f1ac0/Water_heater_881163_control_board/README.md

# Thermostat + ACI pour chauffe eau Pacific - Thermor 881163 et modèles similaires
Le contrôleur de mon chauffe eau a subi un écoulement d'eau qui a suivi la gaine de la sonde et provoqué un court circuit avec la haute tension.

L'achat d'une carte neuve ou occasion étant onéreuse par rapport aux composants présents sur la carte, j'ai opté pour une réparation.En voici un schéma.

Attention il peut y avoir des erreurs dans les relevés des valeurs des composants ; je ne les ai pas dessoudées pour vérifier, notamment les diodes zener. Il peut aussi y avoir d'autres erreurs ou oublis à d'autres endroits !

Pour la sondes de température, il s'agit d'une thermistances CTN 10000 ohms à 25°C avec coefficient B d'environ 3500. Voici les valeurs mesurées lors de l'intervention :
- 11600 ohms à ~24°C
- 698 ohms à ~100°C

Sur mon exemplaire, il a suffi de changer le LM393N, les condensateurs électrolytiques et le transformateur TEZ2.6/D400/9V Fabricant BREVE TUFVASSONS 2,6VA;400VAC;9V;288,8mA. La batterie avait été remplacée depuis longtemps.
