f1ac0/Water_heater_881163_control_board/control_board_front.JPG

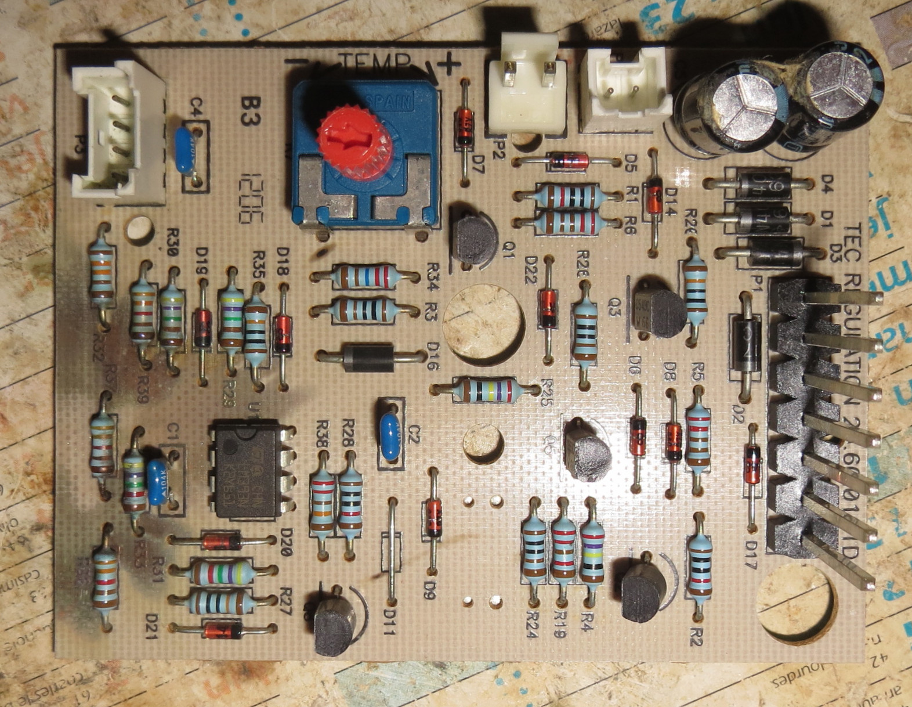
control_board_front.JPG
