f1ac0/Water_heater_881163_control_board/Water_heater_881163_control_board.pdf

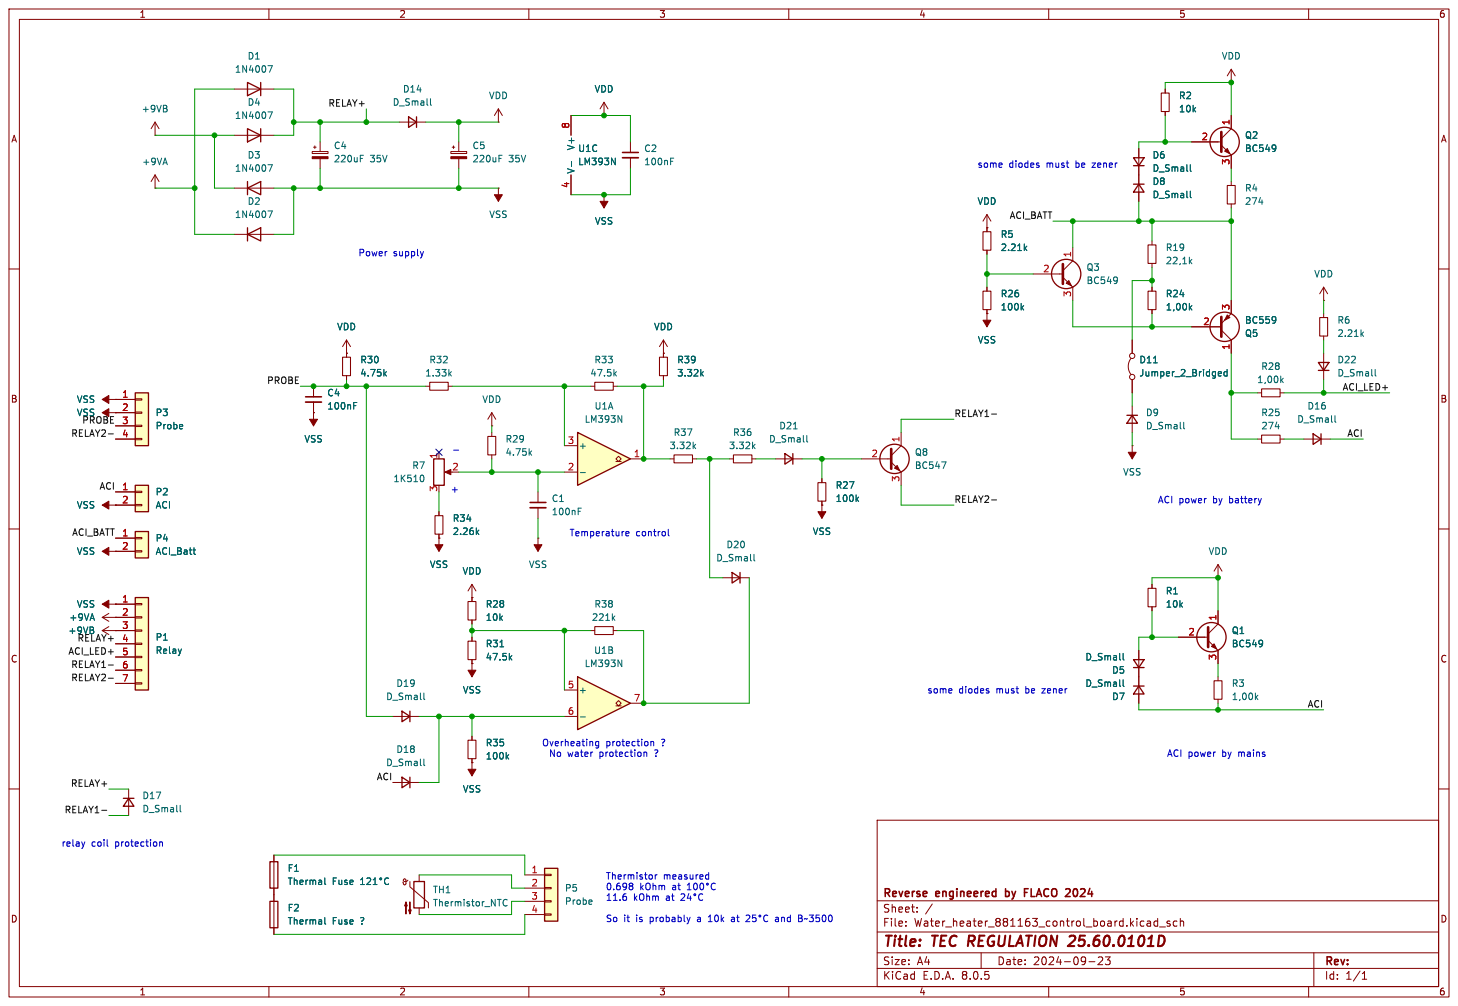
[picture p4: page 1]

some diodes must be zener

Id: 1/1 Title: TEC REGULATION 25.60.0101D
