f1ac0/Water_heater_881163_control_board/Water_heater_881163_control_board.kicad_sch

## KiCad design Water_heater_881163_control_board.kicad_sch (2024-09-23)

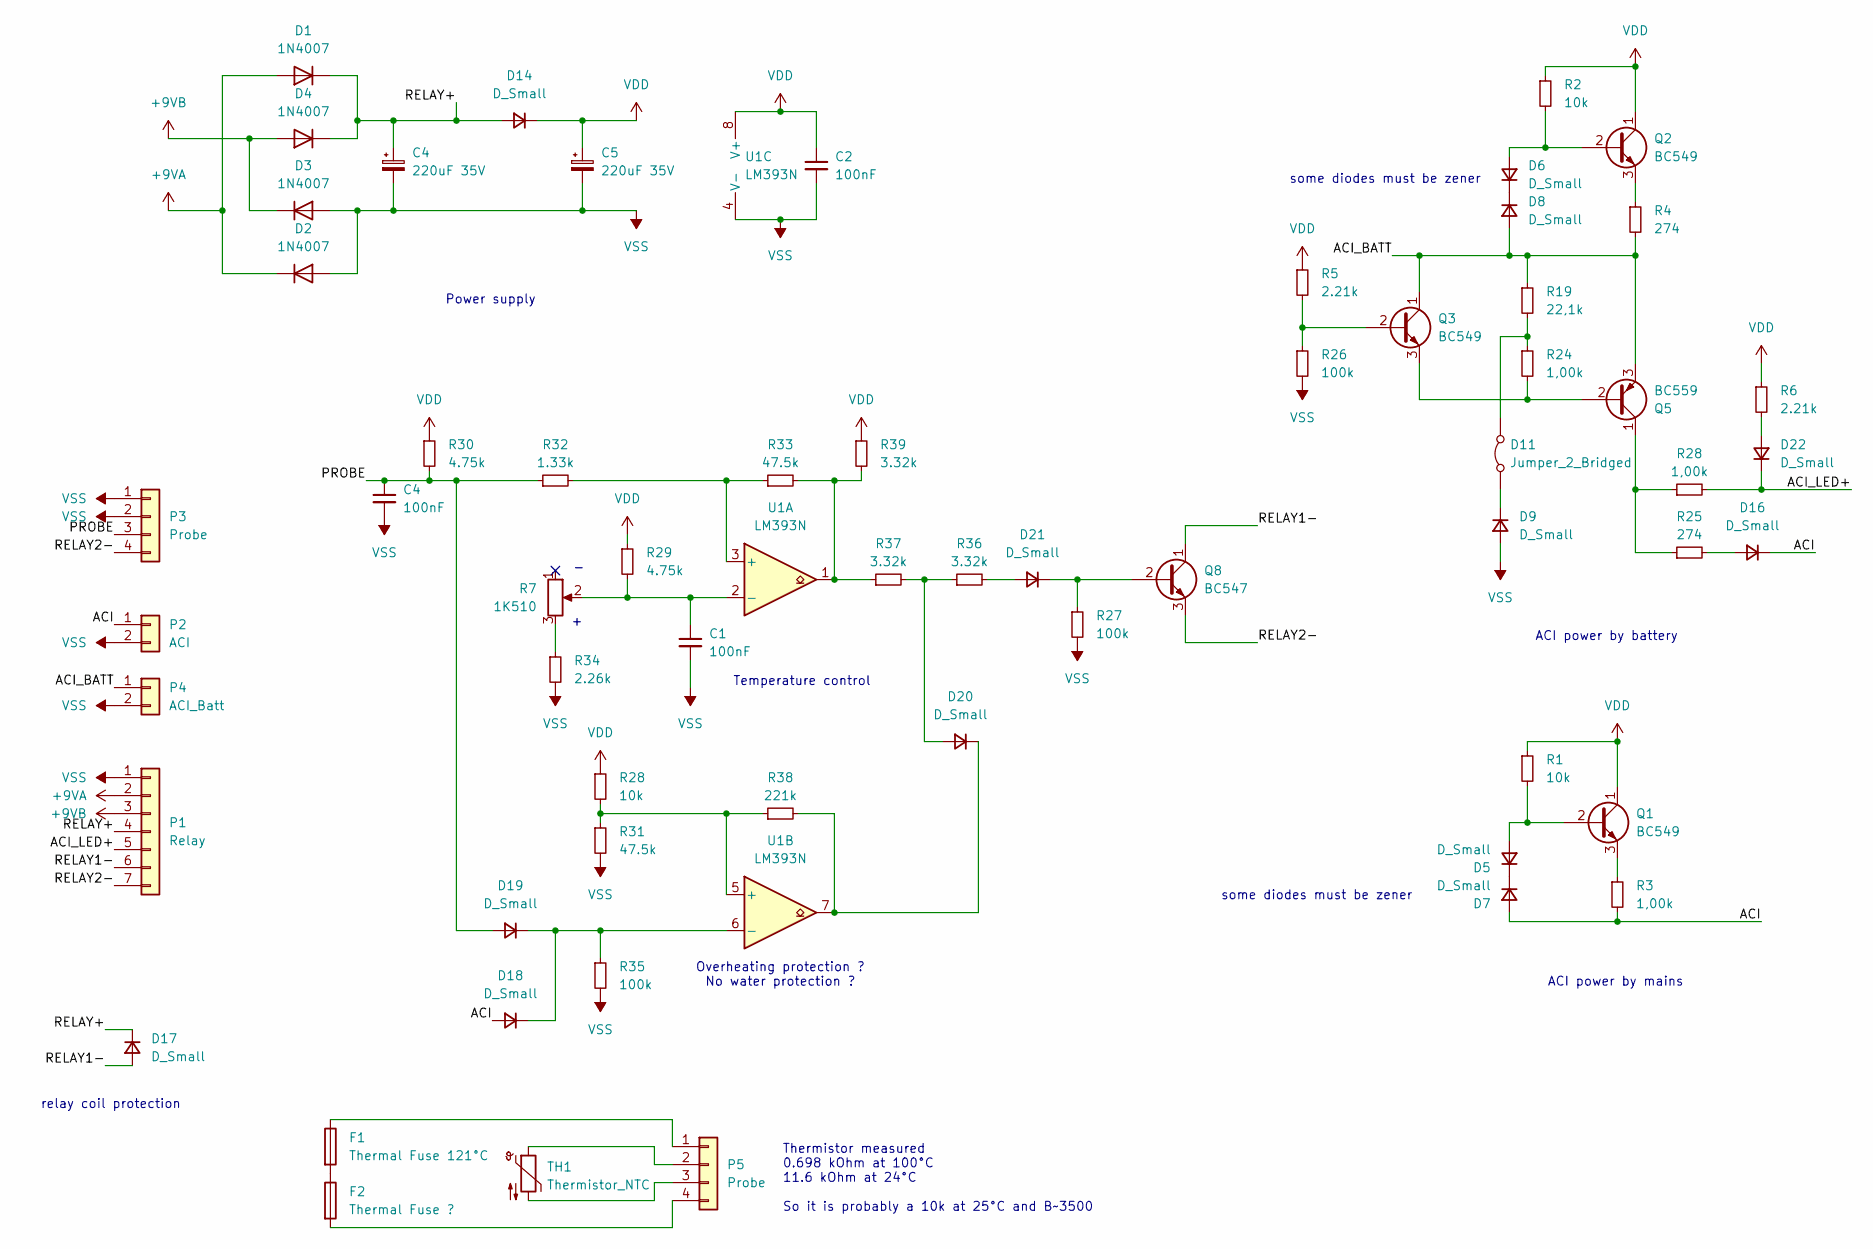
[picture p5: schematic Water_heater_881163_control_board.kicad_sch]

Parts:
C1, C2: 100nF; C_Disc_D5.0mm_W2.5mm_P5.00mm
C4, C5: 220uF 35V; CP_Radial_D10.0mm_P5.00mm
D1, D2, D3, D4: 1N4007; D_DO-41_SOD81_P10.16mm_Horizontal
D5, D6, D7, D8, D9, D14, D16, D17, D18, D19, D20, D21, D22: D_Small
D11: Jumper_2_Bridged
F1: Thermal Fuse 121°C
F2: Thermal Fuse ?
P1: Relay
P2: ACI
P3, P5: Probe
P4: ACI_Batt
Q1, Q2, Q3: BC549; TO-92_Inline
Q5: BC559; TO-92_Inline
Q8: BC547; TO-92_Inline
R1, R2, R28: 10k; R_Axial_DIN0207_L6.3mm_D2.5mm_P10.16mm_Horizontal
R3, R24: 1,00k; R_Axial_DIN0207_L6.3mm_D2.5mm_P10.16mm_Horizontal
R4, R25: 274; R_Axial_DIN0207_L6.3mm_D2.5mm_P10.16mm_Horizontal
R5, R6: 2.21k; R_Axial_DIN0207_L6.3mm_D2.5mm_P10.16mm_Horizontal
R7: 1K510
R19: 22,1k; R_Axial_DIN0207_L6.3mm_D2.5mm_P10.16mm_Horizontal
R26, R27, R35: 100k; R_Axial_DIN0207_L6.3mm_D2.5mm_P10.16mm_Horizontal
R29, R30: 4.75k; R_Axial_DIN0207_L6.3mm_D2.5mm_P10.16mm_Horizontal
R31, R33: 47.5k; R_Axial_DIN0207_L6.3mm_D2.5mm_P10.16mm_Horizontal
R32: 1.33k; R_Axial_DIN0207_L6.3mm_D2.5mm_P10.16mm_Horizontal
R34: 2.26k; R_Axial_DIN0207_L6.3mm_D2.5mm_P10.16mm_Horizontal
R36, R37, R39: 3.32k; R_Axial_DIN0207_L6.3mm_D2.5mm_P10.16mm_Horizontal
R38: 221k; R_Axial_DIN0207_L6.3mm_D2.5mm_P10.16mm_Horizontal
TH1: Thermistor_NTC
U1: LM393N; DIP-8_W7.62mm

Connections:
+9VA: D1.2 (A), D2.1 (K), P1.2
+9VB: D3.1 (K), D4.2 (A), P1.3
ACI: D7.2 (A), D16.1 (K), D18.2 (A), P2.1, R3.2
ACI_BATT: D8.2 (A), P4.1, Q3.1 (C), Q5.3 (E), R4.2, R19.1
ACI_LED+: D22.1 (K), P1.5, R28.2
unnamed: C1.1, R7.2, R29.2, U1.2 (-)
unnamed: D5.1 (K), D7.1 (K)
unnamed: D5.2 (A), Q1.2 (B), R1.2
unnamed: D6.1 (K), D8.1 (K)
unnamed: D6.2 (A), Q2.2 (B), R2.2
unnamed: D9.1 (K), D11.1 (A)
unnamed: D11.2 (B), R19.2, R24.1
unnamed: D16.2 (A), R25.2
unnamed: D18.1 (K), D19.1 (K), R35.1, U1.6 (-)
unnamed: D20.1 (K), R38.2, U1.7
unnamed: D20.2 (A), R36.1, R37.2
unnamed: D21.1 (K), Q8.2 (B), R27.1
unnamed: D21.2 (A), R36.2
unnamed: D22.2 (A), R6.2
unnamed: F1.1, P5.1
unnamed: F1.2, F2.1
unnamed: F2.2, P5.4
unnamed: P5.2, TH1.1
unnamed: P5.3, TH1.2
unnamed: Q1.3 (E), R3.1
unnamed: Q2.3 (E), R4.1
unnamed: Q3.2 (B), R5.2, R26.1
unnamed: Q3.3 (E), Q5.2 (B), R24.2
unnamed: Q5.1 (C), R25.1, R28.1
unnamed: R28.2, R31.1, R38.1, U1.5 (+)
unnamed: R32.2, R33.1, U1.3 (+)
unnamed: R33.2, R37.1, R39.2, U1.1
unnamed: R7.3, R34.1
PROBE: C4.1, D19.2 (A), P3.3, R30.2, R32.1
RELAY1-: D17.2 (A), P1.6, Q8.1 (C)
RELAY2-: P1.7, P3.4, Q8.3 (E)
RELAY+: C4.1, D1.1 (K), D4.1 (K), D14.2 (A), D17.1 (K), P1.4
VDD: C2.1, C5.1, D14.1 (K), Q1.1 (C), Q2.1 (C), R1.1, R2.1, R5.1, R6.1, R28.1, R29.1, R30.1, R39.1, U1.8 (V+)
VSS: C1.2, C2.2, C4.2, C5.2, D2.2 (A), D3.2 (A), D9.2 (A), P1.1, P2.2, P3.1, P3.2, P4.2, R26.2, R27.2, R31.2, R34.2, R35.2, U1.4 (V-)

Notes on the sheet:
ACI power by battery
relay coil protection
Temperature control
Overheating protection ? No water protection ?
ACI power by mains
Thermistor measured 0.698 kOhm at 100°C 11.6 kOhm at 24°C So it is probably a 10k at 25°C and B~3500
some diodes must be zener
Power supply
